gumulka/led-hat/kicad/led_ble_hat.kicad_pcb

## KiCad design kicad/led_ble_hat.kicad_pcb (2024-03-23)

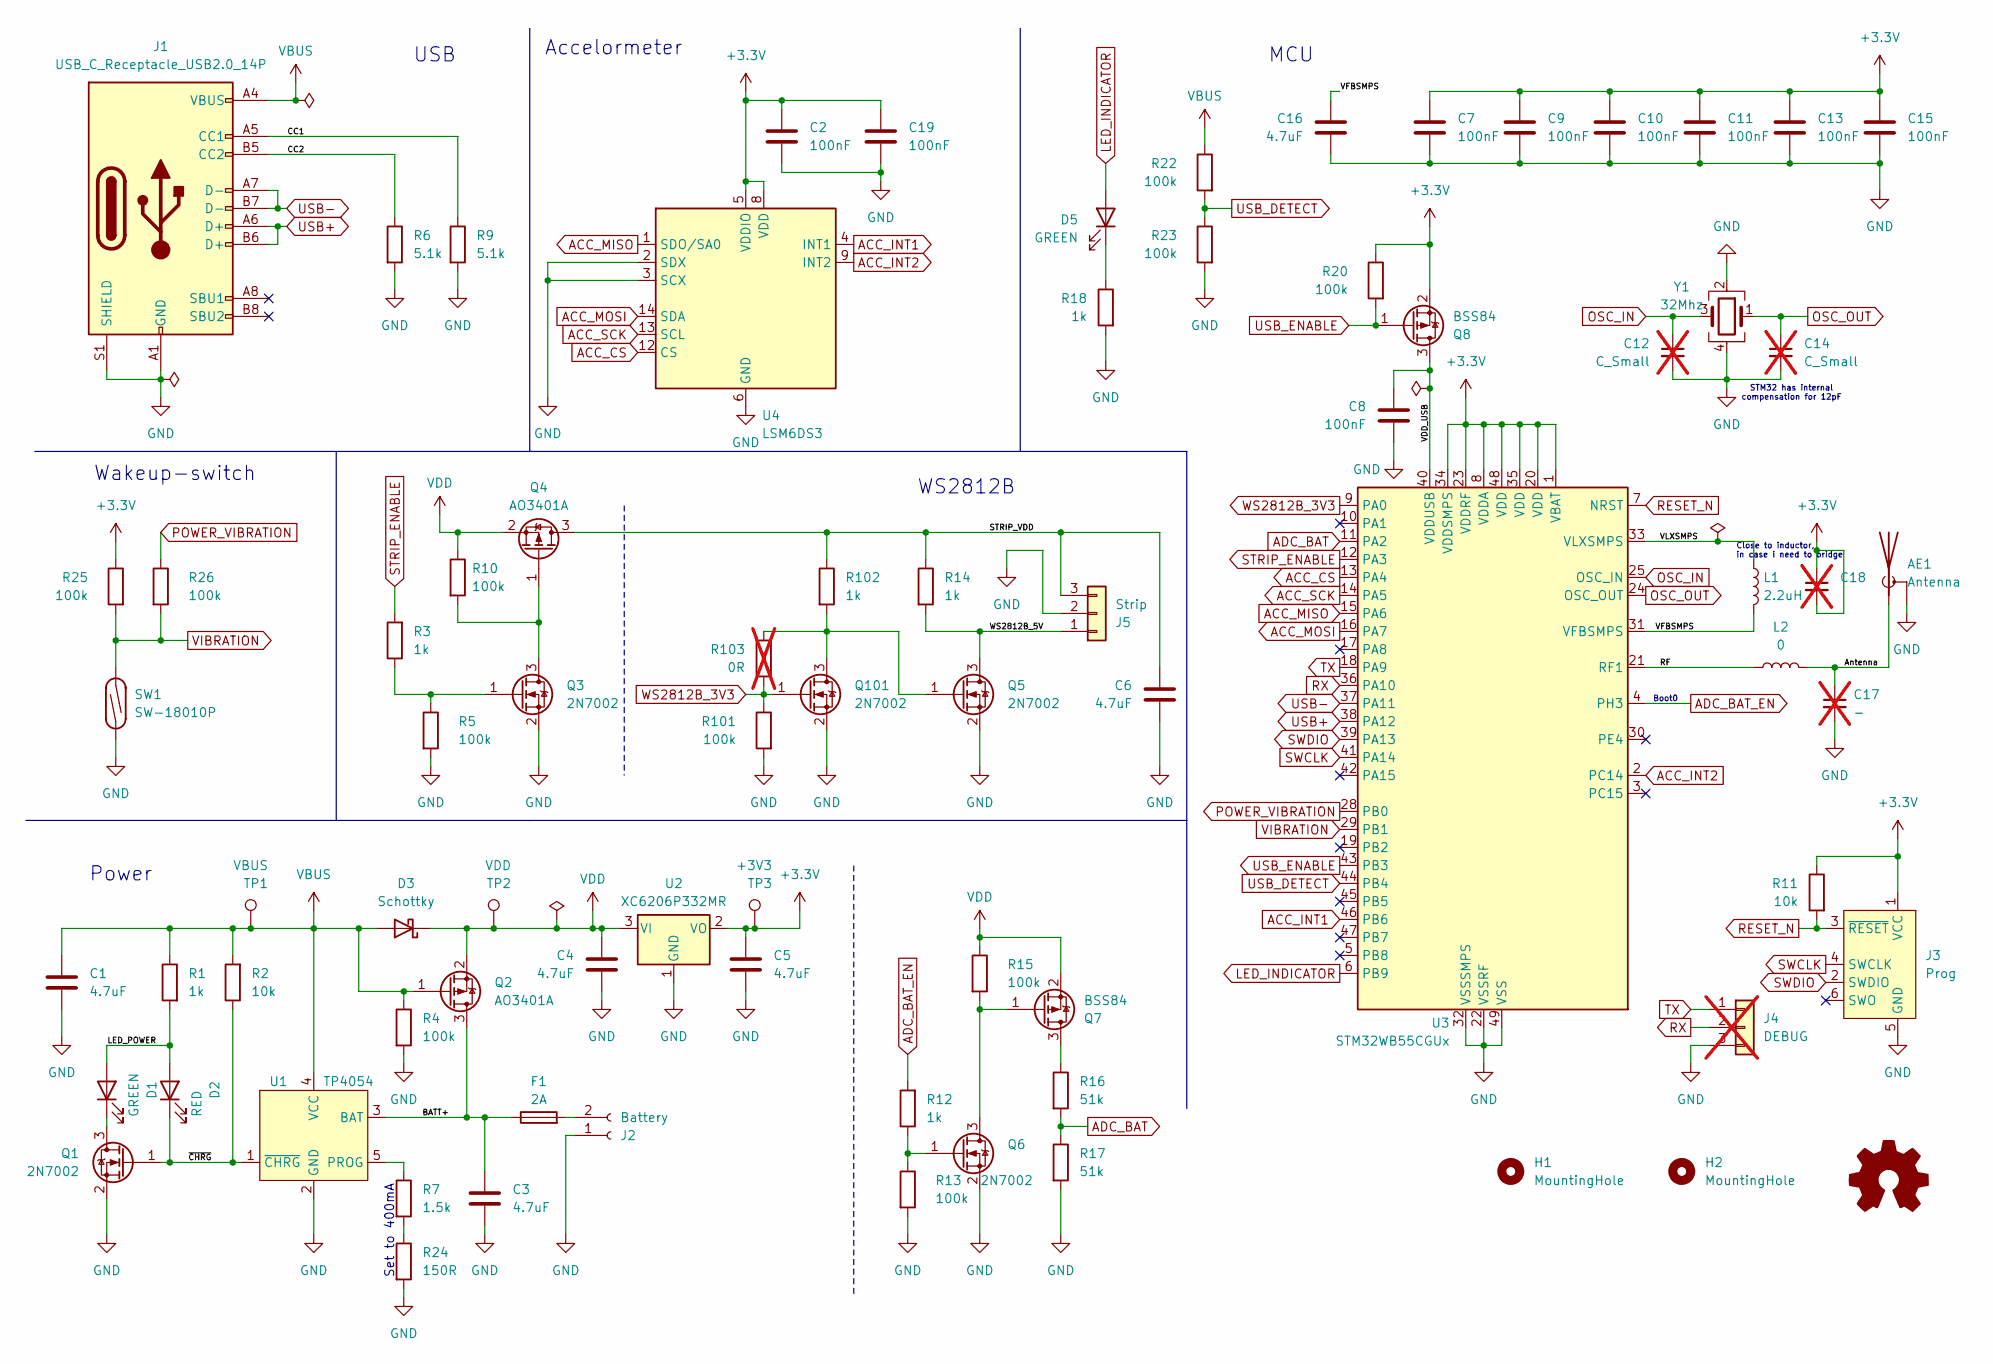
[picture p1: schematic led_ble_hat.kicad_sch, LED Hat]

Parts:
AE1: Antenna; Texas_SWRA117D_2.4GHz_Right
C1, C3, C4, C5, C6, C16: 4.7uF; C_0603_1608Metric; LCSC# C19666
C2, C7, C8, C9, C10, C11, C13, C15, C19: 100nF; C_0402_1005Metric; LCSC# C1525
C12, C14: C_Small; C_0402_1005Metric; not fitted
C17: -; C_0402_1005Metric; not fitted
C18: C_0402_1005Metric; not fitted
D1, D5: GREEN; LED_0603_1608Metric; LCSC# C2986059
D2: RED; LED_0603_1608Metric; LCSC# C2286
D3: Schottky; D_SOD-323; LCSC# C191023
F1: 2A; Fuse_0603_1608Metric; LCSC# C187605
H1, H2: MountingHole; MountingHole_2.1mm
J1: USB_C_Receptacle_USB2.0_14P; GSB1C211110DS1HR
J2: Battery; JST_PH_B2B-PH-K_1x02_P2.00mm_Vertical
J3: Prog; Tag-Connect_TC2030-IDC-NL_2x03_P1.27mm_Vertical
J4: DEBUG; PinHeader_1x03_P2.54mm_Vertical_SMD_Pin1Left; not fitted
J5: Strip; JST_PH_B3B-PH-K_1x03_P2.00mm_Vertical
L1: 2.2uH; L_0805_2012Metric; LCSC# C1043
L2: 0; L_0402_1005Metric; LCSC# C17168
Q1, Q3, Q5, Q6, Q101: 2N7002; SOT-23; LCSC# C7420321
Q2, Q4: AO3401A; SOT-23; LCSC# C15127
Q7, Q8: BSS84; SOT-23; LCSC# C7420340
R1, R3, R12, R18: 1k; R_0402_1005Metric; LCSC# C11702
R2, R11: 10k; R_0402_1005Metric; LCSC# C25744
R4, R5, R10, R13, R15, R20, R22, R23, R25, R26, R101: 100k; R_0402_1005Metric; LCSC# C25741
R6, R9: 5.1k; R_0402_1005Metric; LCSC# C25905
R7: 1.5k; R_0402_1005Metric; LCSC# C25867
R14, R102: 1k; R_0603_1608Metric; LCSC# C25803
R16, R17: 51k; R_0402_1005Metric; LCSC# C25794
R24: 150R; R_0402_1005Metric; LCSC# C25082
R103: 0R; R_0402_1005Metric; not fitted
SW1: SW-18010P; SW-18010P_Vertical
TP1: VBUS; TestPoint_Pad_D1.0mm
TP2: VDD; TestPoint_Pad_D1.0mm
TP3: +3V3; TestPoint_Pad_D1.0mm
U1: TP4054; SOT-23-5; LCSC# C32574
U2: XC6206P332MR; SOT-23-3; LCSC# C5446
U3: STM32WB55CGUx; QFN-48-1EP_7x7mm_P0.5mm_EP5.6x5.6mm; LCSC# C404023
U4: LSM6DS3; LGA-14_3x2.5mm_P0.5mm_LayoutBorder3x4y; LCSC# C967633
Y1: 32Mhz; Crystal_SMD_3225-4Pin_3.2x2.5mm; LCSC# C9009

Connections:
+3.3V: C2.2, C5.1, C7.1, C9.1, C10.1, C11.1, C13.1, C15.1, C18.1, C18.2, C19.2, J3.1 (VCC), Q8.2 (S), R11.1, R20.1, R25.1, TP3.1, U2.2 (VO), U3.1 (VBAT), U3.8 (VDDA), U3.20 (VDD), U3.23 (VDDRF), U3.34 (VDDSMPS), U3.35 (VDD), U3.48 (VDD), U4.5 (VDDIO), U4.8 (VDD)
/Antenna: AE1.1 (A), C17.1, L2.2
/BATT+: C3.1, F1.1, Q2.3 (D), U1.3 (BAT)
/CC1: J1.A5 (CC1), R9.1
/CC2: J1.B5 (CC2), R6.1
/LED_POWER: D1.2 (A), D2.2 (A), R1.2
/RF: L2.1, U3.21 (RF1)
/STRIP_VDD: C6.1, J5.3, Q4.3 (D), R14.1, R102.1
/VDD_USB: C8.1, Q8.3 (D), U3.40 (VDDUSB)
/VFBSMPS: C16.1, L1.2, U3.31 (VFBSMPS)
/VLXSMPS: L1.1, U3.33 (VLXSMPS)
/WS2812B_5V: J5.1, Q5.3 (D), R14.2
/~CHRG: D2.1 (K), Q1.1 (G), R2.1, U1.1 (~CHRG)
ACC_CS: U3.13 (PA4), U4.12 (CS)
ACC_INT1: U3.46 (PB6), U4.4 (INT1)
ACC_INT2: U3.2 (PC14), U4.9 (INT2)
ACC_MISO: U3.15 (PA6), U4.1 (SDO/SA0)
ACC_MOSI: U3.16 (PA7), U4.14 (SDA)
ACC_SCK: U3.14 (PA5), U4.13 (SCL)
ADC_BAT: R16.2, R17.1, U3.11 (PA2)
ADC_BAT_EN: R12.2, U3.4 (PH3)
GND: AE1.2 (Shield), C1.2, C2.1, C3.2, C4.2, C5.2, C6.2, C7.2, C8.2, C9.2, C10.2, C11.2, C12.2, C13.2, C14.2, C15.2, C16.2, C17.2, C19.1, J1.A1 (GND), J1.A12 (GND), J1.B1 (GND), J1.B12 (GND), J1.S1 (SHIELD), J2.1, J3.5 (GND), J4.3, J5.2, Q1.2 (S), Q3.2 (S), Q5.2 (S), Q6.2 (S), Q101.2 (S), R4.2, R5.2, R6.2, R9.2, R13.2, R17.2, R18.2, R23.2, R24.2, R101.2, SW1.1, U1.2 (GND), U2.1 (GND), U3.22 (VSSRF), U3.32 (VSSSMPS), U3.49 (VSS), U4.2 (SDX), U4.3 (SCX), U4.6 (GND), U4.7 (GND), Y1.2, Y1.4
LED_INDICATOR: D5.2 (A), U3.6 (PB9)
unnamed: D1.1 (K), Q1.3 (D)
unnamed: D5.1 (K), R18.1
unnamed: F1.2, J2.2
unnamed: Q3.3 (D), Q4.1 (G), R10.2
unnamed: Q3.1 (G), R3.1, R5.1
unnamed: Q6.3 (D), Q7.1 (G), R15.2
unnamed: Q6.1 (G), R12.1, R13.1
unnamed: Q7.3 (D), R16.1
unnamed: Q5.1 (G), Q101.3 (D), R102.2, R103.2
unnamed: R7.2, R24.1
unnamed: R7.1, U1.5 (PROG)
OSC_IN: C12.1, U3.25 (OSC_IN), Y1.3
OSC_OUT: C14.1, U3.24 (OSC_OUT), Y1.1
POWER_VIBRATION: R26.1, U3.28 (PB0)
RESET_N: J3.3 (~RESET), R11.2, U3.7 (NRST)
RX: J4.2, U3.36 (PA10)
STRIP_ENABLE: R3.2, U3.12 (PA3)
SWCLK: J3.4 (SWCLK), U3.41 (PA14)
SWDIO: J3.2 (SWDIO), U3.39 (PA13)
TX: J4.1, U3.18 (PA9)
USB+: J1.A6 (D+), J1.B6 (D+), U3.38 (PA12)
USB-: J1.A7 (D-), J1.B7 (D-), U3.37 (PA11)
USB_DETECT: R22.2, R23.1, U3.44 (PB4)
USB_ENABLE: Q8.1 (G), R20.2, U3.43 (PB3)
VBUS: C1.1, D3.2 (A), J1.A4 (VBUS), J1.A9 (VBUS), J1.B4 (VBUS), J1.B9 (VBUS), Q2.1 (G), R1.1, R2.2, R4.1, R22.1, TP1.1, U1.4 (VCC)
VDD: C4.1, D3.1 (K), Q2.2 (S), Q4.2 (S), Q7.2 (S), R10.1, R15.1, TP2.1, U2.3 (VI)
VIBRATION: R25.2, R26.2, SW1.2, U3.29 (PB1)
WS2812B_3V3: Q101.1 (G), R101.1, R103.1, U3.9 (PA0)

Notes on the sheet:
Set to 400mA
Boot0
STM32 has internal compensation for 12pF
USB
Power
Wakeup-switch
WS2812B
Close to inductor, in case i need to bridge
Accelormeter
MCU

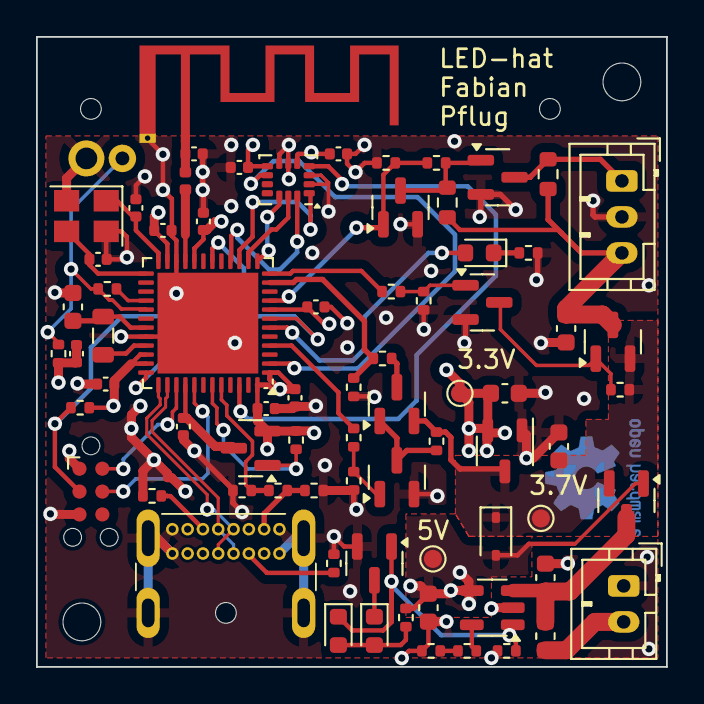
[picture p2: board led_ble_hat.kicad_pcb from above]

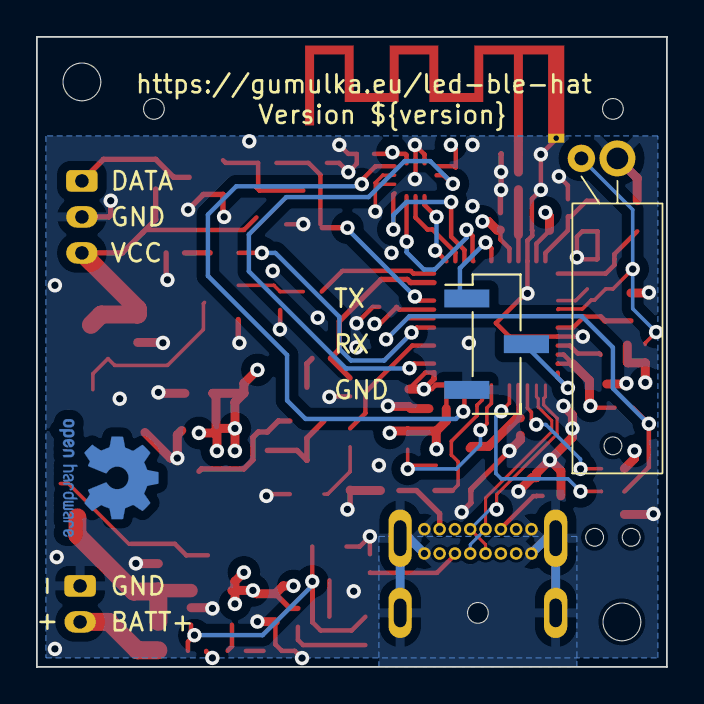
[picture p3: board led_ble_hat.kicad_pcb from below]

Board: 4 copper layers, 35.0 x 35.0 mm, 78 parts (2 on the bottom side), 51 nets.
