gumulka/led-hat/(commit log)

2024-03-03 Move to basic sample of an led-strip
2024-03-03 Add more basic animations
    Animations have a brightness parameter that is currently static, but
    will later be used to adjust the brightness of all the leds.
    Functions return the number of ms to wait between invocations.
2024-03-04 Display random animation on boot
    Display one of the animations at random after reset.
    Add empty animation to display nothing
    [animations.c, animations.h, main.c]
2024-03-04 Add basic bluetooth device information service
    First service to display something via bluetooth. More to come
2024-03-04 Expose important parameter via bluetooth
    Generate 3 bluetooth characteristics to expose my 3 parameters
    * Speed
    * Brightness
    * Animation
    Parameters can be written and read, as well as subscribed to, to change
    the real time behaviour of the led-strip
2024-03-07 Add support for STM32WB55 devboard
2024-03-13 Add first draft of schematic for led-hat
    Not quite ready yet, but a good start to work on it later on.
    There is battery management build into, to run on 3.7 V from LiPo or
    use USB as power source.
    [led_ble_hat.kicad_pcb, led_ble_hat.kicad_sch]
2024-03-13 Replace battery charging ic, rough pcb placement
    Replaced the battery charging ic with something much simpler.
    Did a rough placement of the component onto a pcb for fit
    [led_ble_hat.kicad_pcb, led_ble_hat.kicad_sch]
2024-03-13 Improved routing for PCB
    Also added a vibration sensor on the backside of the PCB
    [led_ble_hat.kicad_pcb, led_ble_hat.kicad_sch]
2024-03-14 Add shake detector and final touches
    PCB should be ready to order now.
    [led_ble_hat.kicad_pcb, led_ble_hat.kicad_sch]
2024-03-18 Add descriptions for connectors
    [led_ble_hat.kicad_pcb]
2024-03-20 Update to Kicad 8
    [led_ble_hat.kicad_pcb, led_ble_hat.kicad_sch]
2024-03-20 Move libraries to a submodule
    I want to have a kind of global library with all of my footprints
    and symbols. So submodule for all projects to share footprints
2024-03-20 Add double inverter for ws2812b output
    [led_ble_hat.kicad_pcb, led_ble_hat.kicad_sch]
2024-03-22 Add accelerometer
    Add an accellerometer and gyroscope to maybe add animations and energy
    savings based on its output.
    [led_ble_hat.kicad_pcb, led_ble_hat.kicad_sch]
2024-03-23 Some final touches
    [led_ble_hat.kicad_pcb, led_ble_hat.kicad_sch]
